GonzalezVictorJavier/Self-balancing-one-wheel-vehicle/Board.brd

## EAGLE design Board.brd (2021-12-21)

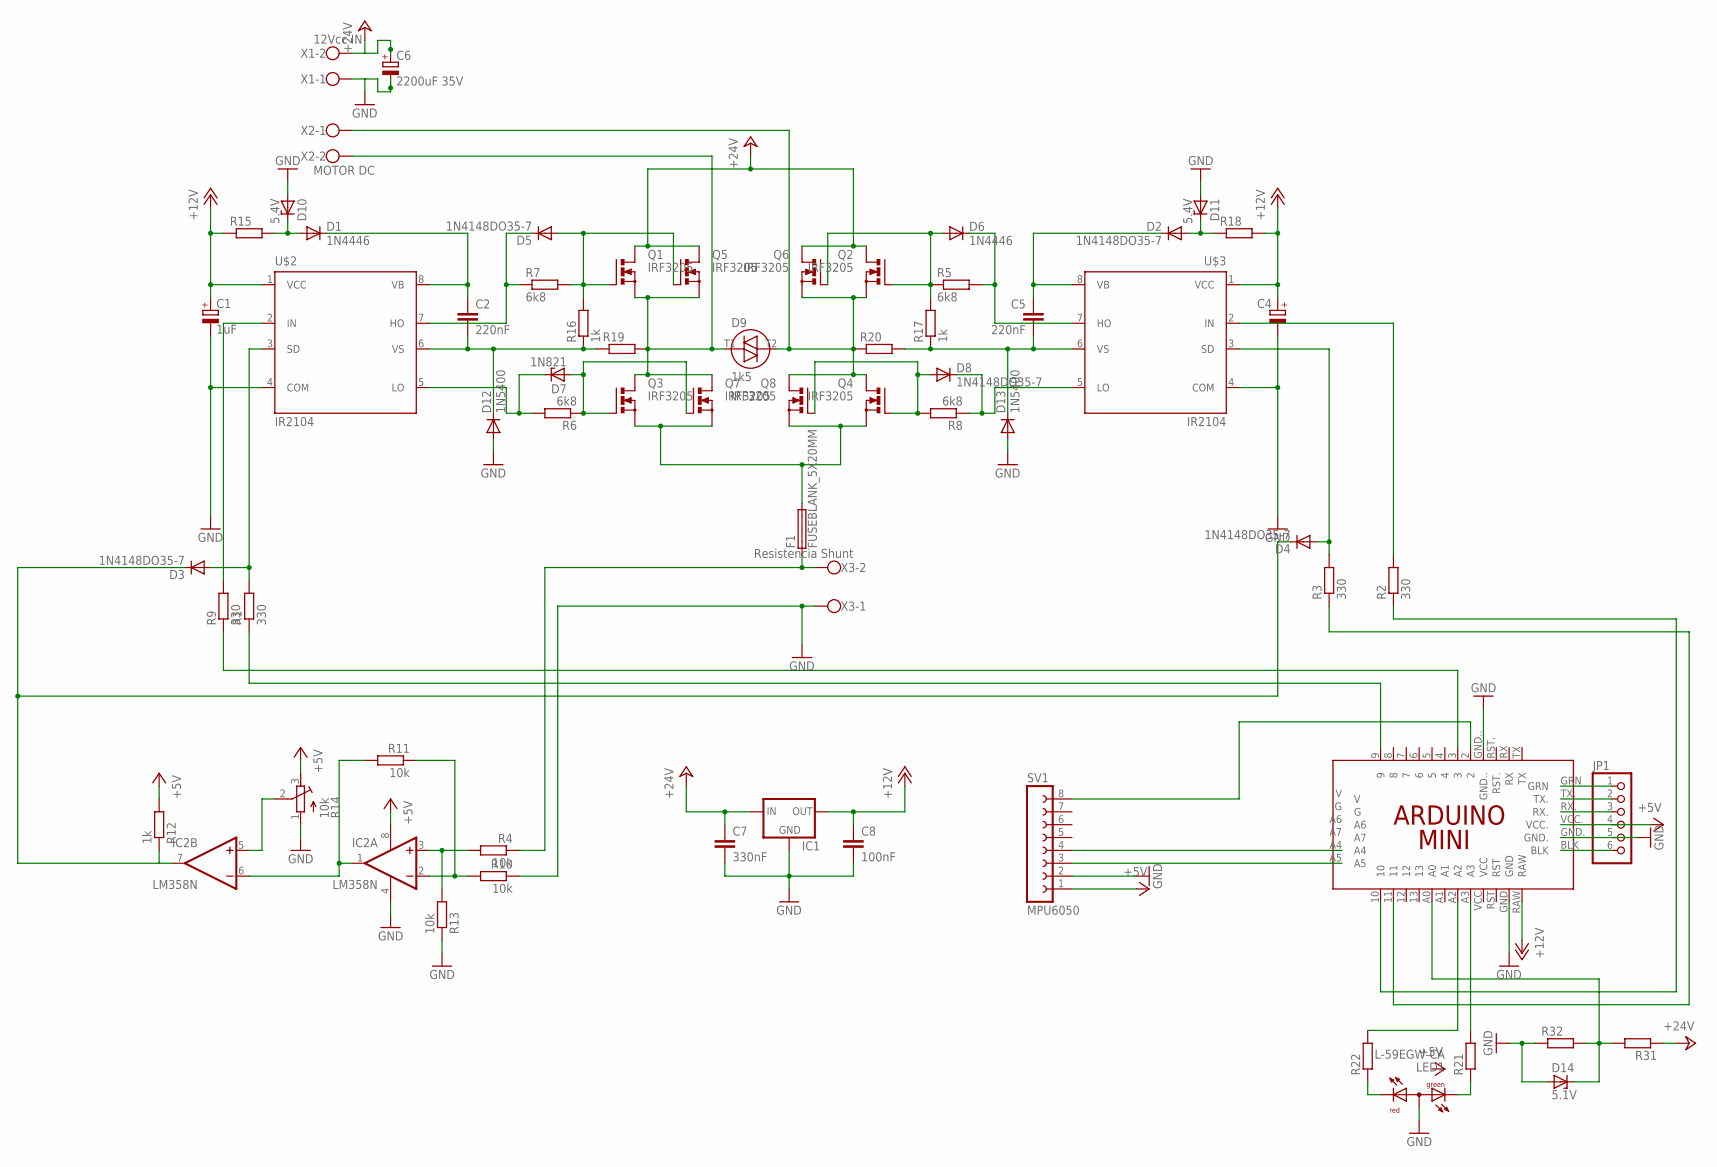
[picture p1: schematic Schematic.sch]

Parts:
C1: 1uF; E3,5-8
C2, C5: 220nF; C075-032X103
C4: CPOL-EUE3.5-8; E3,5-8
C6: 2200uF 35V; E5-13
C7: 330nF; C050-024X044
C8: 100nF; C050-024X044
D1, D6: 1N4446; DO35-10
D2, D3, D4, D5, D8: 1N4148DO35-7; DO35-7
D7: 1N821; DO35Z10
D9: 1k5; BR210S
D10, D11: 5.4V; DO34Z7
D12, D13: 1N5400; DO201-15
D14: 5.1V; DO34Z7
F1: FUSEBLANK_5X20MM; FUSE_HOLDER_5X20MM
IC1: 78XXL
IC2: LM358N; DIL08
JP1: PINHD-1X6; 1X06
LED1: L-59EGW-CA
Q1, Q2, Q3, Q4, Q5, Q6, Q7, Q8: IRF3205; TO220BV
R1: 330; 0204/7
R2, R3: 330; 0207/12
R4, R10, R11, R13: 10k; 0204/7
R5: 6k8; 0207/12
R6: 6k8; 0207/15
R7, R8: 6k8; 0204/7
R9: 330; 0207/10
R12: 1k; 0204/7
R14: 10k; RTRIM64W
R15, R18: R-EU_0204/7; 0204/7
R16, R17: 1k; 0207/10
R19, R20: R-EU_0207/15; 0207/15
R21, R22, R31, R32: R-EU_0204/5; 0204/5
SV1: MPU6050; FE08
U$1: ARDUINO_MINI_PRO+AZUL
U$2, U$3: IR2104
X1: 12Vcc IN; W237-102
X2: MOTOR DC; W237-102
X3: Resistencia Shunt; W237-102

Connections:
+5V: IC2.8 (V+), JP1.4, R12.2, R14.3 (E), SV1.1, U$1.VCC.
+12V: C1.+, C4.+, C8.1, IC1.OUT, R15.1, R18.2, U$1.RAW, U$2.1 (VCC), U$3.1 (VCC)
+24V: C6.+, C7.1, IC1.IN, Q1.D, Q2.D, Q5.D, Q6.D, R31.1, X1.2
GND: C1.-, C4.-, C6.-, C7.2, C8.2, D10.A, D11.A, D12.A, D13.A, D14.A, IC1.GND, IC2.4 (V-), JP1.5, LED1.2 (A), R10.1, R13.1, R14.1 (A), R32.1, SV1.2, U$1.GND, U$1.GND., U$1.GND.., U$2.4 (COM), U$3.4 (COM), X1.1, X3.1
unnamed: R9.2, U$2.2 (IN)
unnamed: C2.1, D1.C, U$2.8 (VB)
unnamed: F1.1, R4.1, X3.2
unnamed: D6.A, Q2.G, Q6.G, R5.1, R17.2
unnamed: R2.2, U$3.2 (IN)
unnamed: D4.A, R3.2, U$3.3 (SD)
unnamed: R1.1, U$1.9
unnamed: D3.C, D4.C, IC2.7 (OUT), R12.1
unnamed: D7.A, Q3.G, Q7.G, R6.1
unnamed: R9.1, U$1.3
unnamed: D8.A, Q4.G, Q8.G, R8.2
unnamed: C2.2, D12.C, R16.1, R19.1, U$2.6 (VS)
unnamed: D5.A, Q1.G, Q5.G, R7.2, R16.2
unnamed: SV1.3, U$1.A5
unnamed: LED1.1 (CR), R22.1
unnamed: D1.A, D10.C, R15.2
unnamed: F1.2, Q3.S, Q4.S, Q7.S, Q8.S
unnamed: R2.1, U$1.10
unnamed: C5.1, D2.C, U$3.8 (VB)
unnamed: SV1.4, U$1.A4
unnamed: IC2.1 (OUT), IC2.6 (-IN), R11.2
unnamed: D5.C, R7.1, U$2.7 (HO)
unnamed: D7.C, R6.2, U$2.5 (LO)
unnamed: D8.C, R8.1, U$3.5 (LO)
unnamed: D6.C, R5.2, U$3.7 (HO)
unnamed: IC2.3 (+IN), R4.2, R13.2
unnamed: D3.A, R1.2, U$2.3 (SD)
unnamed: D2.A, D11.C, R18.1
unnamed: LED1.3 (CG), R21.1
unnamed: IC2.2 (-IN), R10.2, R11.1
unnamed: IC2.5 (+IN), R14.2 (S)
unnamed: R3.1, U$1.11
unnamed: D9.T2, Q2.S, Q4.D, Q6.S, Q8.D, R20.1, X2.1
unnamed: D9.T1, Q1.S, Q3.D, Q5.S, Q7.D, R19.2, X2.2
unnamed: C5.2, D13.C, R17.1, R20.2, U$3.6 (VS)
unnamed: SV1.8, U$1.2
unnamed: R21.2, U$1.A3
unnamed: R22.2, U$1.A2
unnamed: JP1.6, U$1.BLK
unnamed: JP1.3, U$1.RX.
unnamed: JP1.2, U$1.TX.
unnamed: JP1.1, U$1.GRN
unnamed: D14.C, R31.2, R32.2, U$1.A0

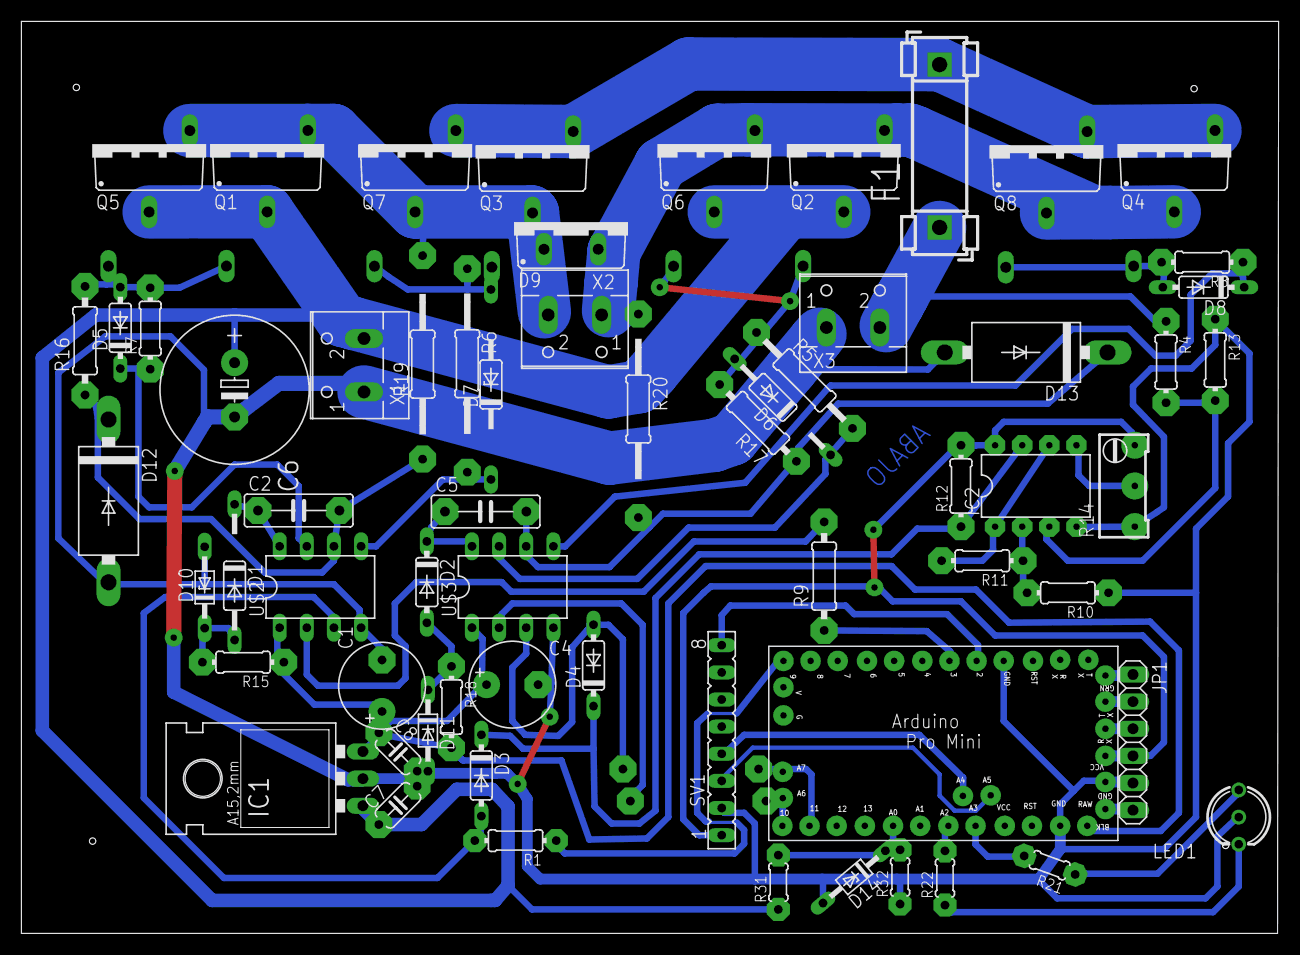
[picture p2: board Board.brd from above]

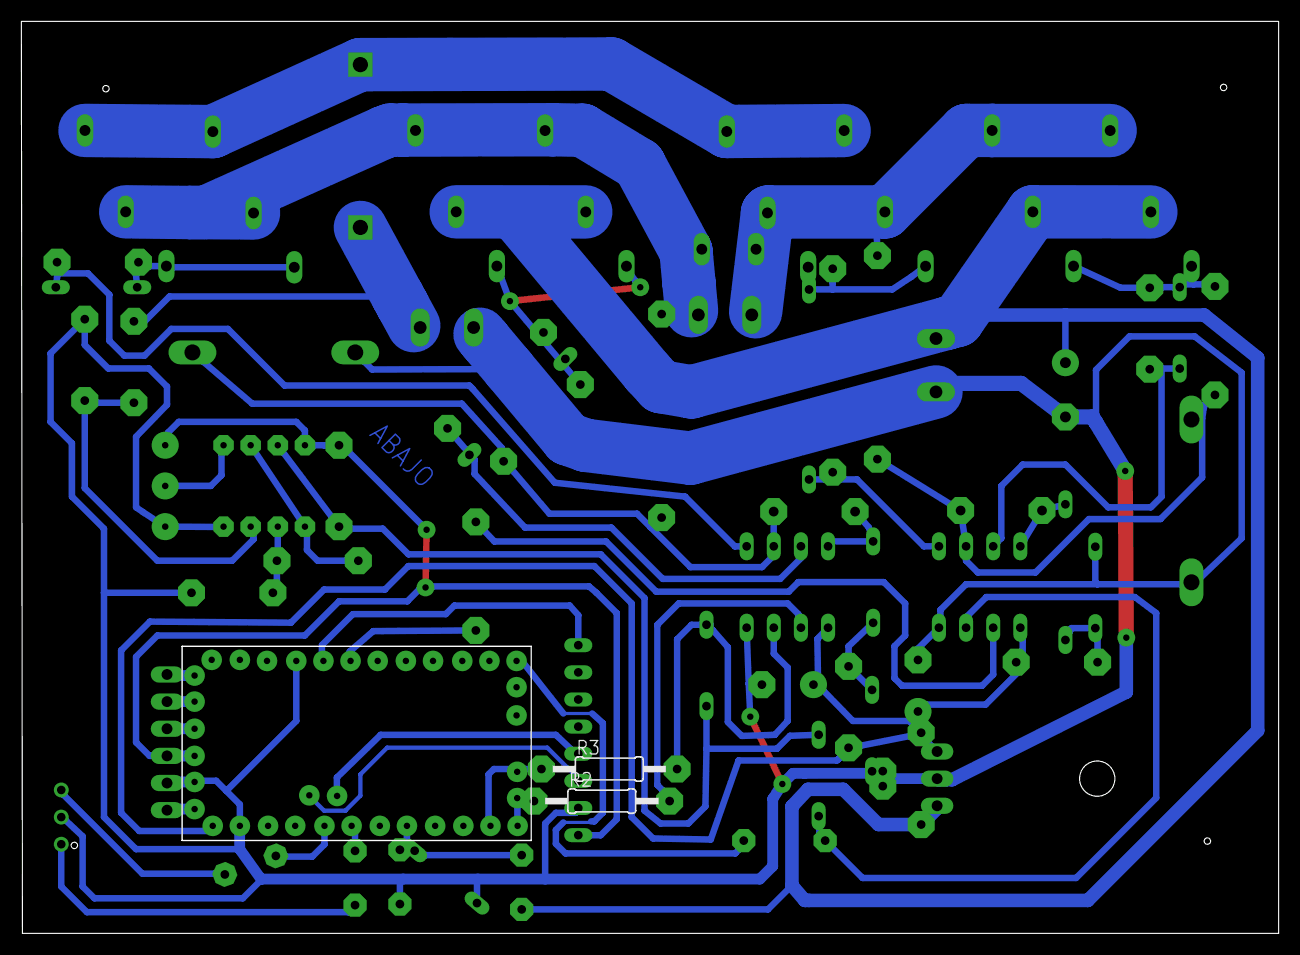
[picture p3: board Board.brd from below]

Board: 2 copper layers, 117.7 x 85.4 mm, 65 parts (2 on the bottom side), 47 nets.
