GonzalezVictorJavier/Self-balancing-one-wheel-vehicle/Code.ino

  //#include <TimerOne.h>

// I2C device class (I2Cdev) demonstration Arduino sketch for MPU6050 class using DMP (MotionApps v2.0)
// 6/21/2012 by Jeff Rowberg <jeff@rowberg.net>
// Updates should (hopefully) always be available at https://github.com/jrowberg/i2cdevlib
//
// Changelog:
//      2013-05-08 - added seamless Fastwire support
//                 - added note about gyro calibration
//      2012-06-21 - added note about Arduino 1.0.1 + Leonardo compatibility error
//      2012-06-20 - improved FIFO overflow handling and simplified read process
//      2012-06-19 - completely rearranged DMP initialization code and simplification
//      2012-06-13 - pull gyro and accel data from FIFO packet instead of reading directly
//      2012-06-09 - fix broken FIFO read sequence and change interrupt detection to RISING
//      2012-06-05 - add gravity-compensated initial reference frame acceleration output
//                 - add 3D math helper file to DMP6 example sketch
//                 - add Euler output and Yaw/Pitch/Roll output formats
//      2012-06-04 - remove accel offset clearing for better results (thanks Sungon Lee)
//      2012-06-01 - fixed gyro sensitivity to be 2000 deg/sec instead of 250
//      2012-05-30 - basic DMP initialization working

/* ============================================
I2Cdev device library code is placed under the MIT license
Copyright (c) 2012 Jeff Rowberg

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
THE SOFTWARE IS PROVIDED "AS IS", WITHOUT WARRANTY OF ANY KIND, EXPRESS OR
IMPLIED, INCLUDING BUT NOT LIMITED TO THE WARRANTIES OF MERCHANTABILITY,
FITNESS FOR A PARTICULAR PURPOSE AND NONINFRINGEMENT. IN NO EVENT SHALL THE
AUTHORS OR COPYRIGHT HOLDERS BE LIABLE FOR ANY CLAIM, DAMAGES OR OTHER
LIABILITY, WHETHER IN AN ACTION OF CONTRACT, TORT OR OTHERWISE, ARISING FROM,
OUT OF OR IN CONNECTION WITH THE SOFTWARE OR THE USE OR OTHER DEALINGS IN
THE SOFTWARE.
===============================================
*/

// I2Cdev and MPU6050 must be installed as libraries, or else the .cpp/.h files
// for both classes must be in the include path of your project
#include "I2Cdev.h"
#include "MPU6050_6Axis_MotionApps20.h"
//#include "MPU6050.h" // not necessary if using MotionApps include file
// Arduino Wire library is required if I2Cdev I2CDEV_ARDUINO_WIRE implementation
// is used in I2Cdev.h
#if I2CDEV_IMPLEMENTATION == I2CDEV_ARDUINO_WIRE
    #include "Wire.h"
#endif



MPU6050 mpu;
//MPU6050 mpu(0x69); // <-- use for AD0 high

/* =========================================================================
   NOTE: In addition to connection 3.3v, GND, SDA, and SCL, this sketch
   depends on the MPU-6050's INT pin being connected to the Arduino's
   external interrupt #0 pin. On the Arduino Uno and Mega 2560, this is
   digital I/O pin 2.
 * ========================================================================= */

/* =========================================================================
   NOTE: Arduino v1.0.1 with the Leonardo board generates a compile error
   when using Serial.write(buf, len). The Teapot output uses this method.
   The solution requires a modification to the Arduino USBAPI.h file, which
   is fortunately simple, but annoying. This will be fixed in the next IDE
   release. For more info, see these links:

   http://arduino.cc/forum/index.php/topic,109987.0.html
   http://code.google.com/p/arduino/issues/detail?id=958
 * ========================================================================= */
// uncomment "OUTPUT_READABLE_YAWPITCHROLL" if you want to see the yaw/
// pitch/roll angles (in degrees) calculated from the quaternions coming
// from the FIFO. Note this also requires gravity vector calculations.
// Also note that yaw/pitch/roll angles suffer from gimbal lock (for
// more info, see: http://en.wikipedia.org/wiki/Gimbal_lock)
#define OUTPUT_READABLE_YAWPITCHROLL

// uncomment "OUTPUT_READABLE_REALACCEL" if you want to see acceleration
// components with gravity removed. This acceleration reference frame is
// not compensated for orientation, so +X is always +X according to the
// sensor, just without the effects of gravity. If you want acceleration
// compensated for orientation, us OUTPUT_READABLE_WORLDACCEL instead.
#define OUTPUT_READABLE_REALACCEL

// MPU control/status vars
bool dmpReady = false;  // set true if DMP init was successful
uint8_t mpuIntStatus;   // holds actual interrupt status byte from MPU
uint8_t devStatus;      // return status after each device operation (0 = success, !0 = error)
uint16_t packetSize;    // expected DMP packet size (default is 42 bytes)
uint16_t fifoCount;     // count of all bytes currently in FIFO
uint8_t fifoBuffer[64]; // FIFO storage buffer

// orientation/motion vars
Quaternion q;           // [w, x, y, z]         quaternion container
VectorInt16 aa;         // [x, y, z]            accel sensor measurements
VectorInt16 aaReal;     // [x, y, z]            gravity-free accel sensor measurements
VectorInt16 aaWorld;    // [x, y, z]            world-frame accel sensor measurements
VectorFloat gravity;    // [x, y, z]            gravity vector
float ypr[3];           // [yaw, pitch, roll]   yaw/pitch/roll container and gravity vector

int16_t gx, gy, gz;


// ================================================================
// ===               INTERRUPT DETECTION ROUTINE                ===
// ================================================================

volatile bool mpuInterrupt = false;     // indicates whether MPU interrupt pin has gone high
void dmpDataReady() {
    mpuInterrupt = true;
}

//=============Inicialización de variables control driver===========
float duty = 0;
float anguloAnterior = 0;
//==================================================================
//=============Parámetros de configuración del driver===============
  //_____Lo que tiene q ver con el modelo resorte-amortiguador________
    #define ohmega 400.
    #define epsilon 15.
    #define dutyDerivConst 0.0025
  //_____Seteo de valores para el giróscopo___________________________  
    #define dutyFreno 10.
    #define anguloMuerto 0
    #define valorEsperado -10.
    #define errorMaximo 18
  //_____Seteo PWM____________________________________________________
    #define resolucionPWM 150

//==================================================================
//=======Cosas útiles para el driver================================
boolean flagMotorEncendido;
//==================================================================
//=======Definición de pines de los drivers ( tipo IR2104)==========
#define sdU1 9
#define clU1 3
#define sdU2 11
#define clU2 10
#define sensorCorriente 7
//==================================================================

unsigned long lastTime;
double Input ,Output ,Setpoint ;
double errSum ,lastErr ;
boolean flagPrimeraVez = true;

ISR(PCINT2_vect )
{
  if (digitalRead (sensorCorriente) == LOW)
  {
    flagMotorEncendido = false;
    digitalWrite(13, HIGH);
  }  
}

// ================================================================
// ===                      INITIAL SETUP                       ===
// ================================================================
void setup() {
//initialize all timers except for 0, to save time keeping functions
//    InitTimers(); 
//    lastTime = millis();
  TCCR1B = TCCR1B & 0b11111000 | 0x03;                                     //Seteamos el prescaler en 64 en ambos q son unos 490Hz
  TCCR2B = TCCR2B & 0b11111000 | 0x04;
  pinMode(clU1, OUTPUT);
  pinMode(clU2, OUTPUT);
  pinMode(sdU1, OUTPUT);
  pinMode(sdU2, OUTPUT);
  pinMode(sensorCorriente, INPUT);
  pinMode(13, OUTPUT);
  digitalWrite (sensorCorriente, HIGH);  // internal pull-up resistor
  PCMSK2 |= bit (PCINT23);  // want pin 7
  PCIFR  |= bit (PCIF2);   // clear any outstanding interrupts
  PCICR  |= bit (PCIE2);   // enable pin change interrupts for D8 to D13
  /*    pinMode(5, OUTPUT);                                                  //PWM en un sentido                                      
    SetPinFrequency(5, frecuenciaPWM);
    pwmWrite(5, 0);

    pinMode(3, OUTPUT);                                                  //PWM en un sentido                                      
    SetPinFrequency(3, frecuenciaPWM);
    pwmWrite(3, 0);

    pinMode(9, OUTPUT);                                                  //PWM en un sentido                                      
    SetPinFrequency(9, frecuenciaPWM);
    pwmWrite(9, 0);

    pinMode(10, OUTPUT);                                                  //PWM en un sentido                                      
    SetPinFrequency(10, frecuenciaPWM);
    pwmWrite(10, 0);
 */
  flagMotorEncendido = true;
   Setpoint = valorEsperado;
    // join I2C bus (I2Cdev library doesn't do this automatically)
    #if I2CDEV_IMPLEMENTATION == I2CDEV_ARDUINO_WIRE
        Wire.begin();
        TWBR = 24; // 400kHz I2C clock (200kHz if CPU is 8MHz)
    #elif I2CDEV_IMPLEMENTATION == I2CDEV_BUILTIN_FASTWIRE
        Fastwire::setup(400, true);
    #endif

    // initialize serial communication
    // (115200 chosen because it is required for Teapot Demo output, but it's
    // really up to you depending on your project)
    Serial.begin(115200);
    while (!Serial); // wait for Leonardo enumeration, others continue immediately

    // NOTE: 8MHz or slower host processors, like the Teensy @ 3.3v or Ardunio
    // Pro Mini running at 3.3v, cannot handle this baud rate reliably due to
    // the baud timing being too misaligned with processor ticks. You must use
    // 38400 or slower in these cases, or use some kind of external separate
    // crystal solution for the UART timer.

    // initialize device
    Serial.println(F("Initializing I2C devices..."));
    mpu.initialize();

    // verify connection
    Serial.println(F("Testing device connections..."));
    Serial.println(mpu.testConnection() ? F("MPU6050 connection successful") : F("MPU6050 connection failed"));

    // wait for ready
    Serial.println(F("\nSend any character to begin DMP programming and demo: "));
    while (Serial.available() && Serial.read()); // empty buffer
                                                                    //    while (!Serial.available());                 // wait for data
                                                                    //    while (Serial.available() && Serial.read()); // empty buffer again

    // load and configure the DMP
    Serial.println(F("Initializing DMP..."));
    devStatus = mpu.dmpInitialize();

    // supply your own gyro offsets here, scaled for min sensitivity
    mpu.setXGyroOffset(0);
    mpu.setYGyroOffset(0);
    mpu.setZGyroOffset(0);
    // make sure it worked (returns 0 if so)
    if (devStatus == 0) {
        // turn on the DMP, now that it's ready
        Serial.println(F("Enabling DMP..."));
        mpu.setDMPEnabled(true);

        // enable Arduino interrupt detection
        Serial.println(F("Enabling interrupt detection (Arduino external interrupt 0)..."));
        attachInterrupt(0, dmpDataReady, RISING);
        mpuIntStatus = mpu.getIntStatus();

        // set our DMP Ready flag so the main loop() function knows it's okay to use it
        Serial.println(F("DMP ready! Waiting for first interrupt..."));
        dmpReady = true;

        // get expected DMP packet size for later comparison
        packetSize = mpu.dmpGetFIFOPacketSize();
    } else {
        // ERROR!
        // 1 = initial memory load failed
        // 2 = DMP configuration updates failed
        // (if it's going to break, usually the code will be 1)
        Serial.print(F("DMP Initialization failed (code "));
        Serial.print(devStatus);
        Serial.println(F(")"));
    }
}


// ================================================================
// ===                    MAIN PROGRAM LOOP                     ===
// ================================================================

void loop() {
    // if programming failed, don't try to do anything
    if (!dmpReady) return;

    // wait for MPU interrupt or extra packet(s) available
    while (!mpuInterrupt && fifoCount < packetSize) {
        // other program behavior stuff here
        // .
        // .
        // .
        // if you are really paranoid you can frequently test in between other
        // stuff to see if mpuInterrupt is true, and if so, "break;" from the
        // while() loop to immediately process the MPU data
        // .
        // .
        // .
    }

    // reset interrupt flag and get INT_STATUS byte
    mpuInterrupt = false;
    mpuIntStatus = mpu.getIntStatus();

    // get current FIFO count
    fifoCount = mpu.getFIFOCount();

    // check for overflow (this should never happen unless our code is too inefficient)
    if ((mpuIntStatus & 0x10) || fifoCount == 1024) {
        // reset so we can continue cleanly
        mpu.resetFIFO();
        Serial.println(F("FIFO overflow!"));

    // otherwise, check for DMP data ready interrupt (this should happen frequently)
    } else if (mpuIntStatus & 0x02) {
        // wait for correct available data length, should be a VERY short wait
        while (fifoCount < packetSize) fifoCount = mpu.getFIFOCount();

        // read a packet from FIFO
        mpu.getFIFOBytes(fifoBuffer, packetSize);
        
        // track FIFO count here in case there is > 1 packet available
        // (this lets us immediately read more without waiting for an interrupt)
        fifoCount -= packetSize;

        #ifdef OUTPUT_READABLE_YAWPITCHROLL
            // display Euler angles in degrees
            mpu.dmpGetQuaternion(&q, fifoBuffer);
            mpu.dmpGetGravity(&gravity, &q);
            mpu.dmpGetYawPitchRoll(ypr, &q, &gravity);                          //Adquiere los componentes YAW, PITCH y ROL de la retación, discriminando la gravedad.
        #endif

        #ifdef OUTPUT_READABLE_REALACCEL
            // display real acceleration, adjusted to remove gravity
            mpu.dmpGetQuaternion(&q, fifoBuffer);                              //Adquiere nuevamente el Quaternion para tener una versión actualizada del mismo.
            mpu.dmpGetAccel(&aa, fifoBuffer);                                  
            mpu.dmpGetGravity(&gravity, &q);
            mpu.dmpGetLinearAccel(&aaReal, &aa, &gravity);                     //Adquiere la aceleración lineal, no se si esto no esta al pedo.. habria q probarlo porq mepa q antes usabamos esta y despues terminamos usando la de abajo nomas q es la aceleracion angular sobre x. 
            mpu.getRotation(&gx, &gy, &gz);                                    //Tomamos todas las aceleraciones angulares.
            calcularDuty(ypr[0] * 180/M_PI,ypr[1] * 180/M_PI,ypr[2] * 180/M_PI, aaReal,gz);  //LLamamos a la función que calcula y controla el duty... ????Ver q hay algunos parámetros q se pasn al pedo.. solo para graficar   
          #endif

    }
}

void calcularDuty(float medicionZ,float medicionX,float medicionY, VectorInt16 aceleracion ,int16_t accRotZ){  
  //=============Cálculo del Duty con los valores sensados========================== 
  float medicionCentrada = medicionX - valorEsperado;                                    //Ubica la medicion en el centro de las mediciones con el valorEsperado en 0  
  float dutyDeriv =   ohmega * medicionCentrada - aceleracion.x + epsilon * accRotZ;     //Ecuación que modela el sistema con el resorte-amortiguador... Devuelve la derivada del duty 
  //================================================================================
  //=============Si el sensor se va a 0, el duty va a 0 y se frena el motor=========  
  if(flagMotorEncendido == true)
  {
    duty += dutyDerivConst * dutyDeriv;                                                    //Se modifica el duty en base a la derivada anteriormente calculada.  
  }
  else
  {
      duty = 0;
  }
  duty = max(min(duty ,resolucionPWM ), - resolucionPWM);                                //Se recorta el duty en función de su resolución.
  //================================================================================
  //=============Si el duty está cercano a su valor central, clava las guampas======  
  if(duty < dutyFreno && duty > (- dutyFreno))
  {
    analogWrite(sdU1 ,255 );
    analogWrite(sdU2 ,255 );
    analogWrite(clU1, 0);  
    analogWrite(clU2, 0);  
   }
/*
  //===============================================================================
  //=============Si el Duty es negativo, va para un lado===========================
   else
   {
     if(duty < 0)
     {
       //__________Tiramos abajo los SHUT_DOWN por las dudas antes de cambiar_______
       analogWrite(sdU1 ,0 );                        
       analogWrite(sdU2 ,0 );    
       //__________Tiramos abajo los SHUT_DOWN por las dudas antes de cambiar_______
       analogWrite(clU1,  (uint8_t) abs(duty));  
       analogWrite(clU2 ,0);    
       analogWrite(sdU2, (uint8_t) abs(duty));  
       analogWrite(sdU1 ,255 );    
     }
    //===============================================================================
    //==============Si el Duty es positivo, va para el otro==========================
     else
     {
    //__________Tiramos abajo los SHUT_DOWN por las dudas antes de cambiar_______
       analogWrite(sdU1 ,0 );    
       analogWrite(sdU2 ,0 );    
       //__________Tiramos abajo los SHUT_DOWN por las dudas antes de cambiar_______
       analogWrite(clU2, (uint8_t) abs(duty));  
       analogWrite(clU1 ,0);
       analogWrite(sdU1, (uint8_t) abs(duty));  
       analogWrite(sdU2 ,255);
     }
   }
*/

  //===============================================================================
  //=============Si el Duty es negativo, va para un lado===========================
   else
   {
     if(duty < 0)
     {
       //__________Tiramos abajo los SHUT_DOWN por las dudas antes de cambiar_______
       analogWrite(clU1,  255);  
       analogWrite(clU2 ,0);    
       analogWrite(sdU1, (uint8_t) abs(duty));  
       analogWrite(sdU2 ,255 );    
     }
    //===============================================================================
    //==============Si el Duty es positivo, va para el otro==========================
     else
     {
       //__________Tiramos abajo los SHUT_DOWN por las dudas antes de cambiar_______
       analogWrite(clU2, 255);  
       analogWrite(clU1 ,0);
       analogWrite(sdU2, (uint8_t) abs(duty));  
       analogWrite(sdU1 ,255);
     }
   }

/*  

                                                                Serial.print("  ROTY\t");
                                                                Serial.print(medicionY);
                                                                 Serial.print("  ACCY  \t");
                                                                Serial.print(aceleracion.y);
                                                                 Serial.print("  ACCROTX  \t");
                                                                Serial.print(accRotX);
                                                                 Serial.print("  PWM\t");
                                                                Serial.print(duty);
                                                                 Serial.print("  DUTYDERIV  \t");
                                                                Serial.print(dutyDeriv);
                                                                 Serial.print("  DIRECCION\t");
                                                          if(medicionCentrada > anguloAnterior)
                                                          
                                                                 Serial.print("  adelante");
                                                                 else
                                                                 Serial.print("  atras");
                                                                 
                                                                 Serial.print("\n");
                                                          anguloAnterior = medicionCentrada;    
*/
}
