GonzalezVictorJavier/Self-balancing-one-wheel-vehicle/(commit log)

2021-12-21 Ver 1
    This is only the board, just for testing of a home-made H bridge to control the motor.
    [Board.brd, Schematic.sch]
2021-12-21 Ver 2
    Board: A new design using a IC H bridge driver properly calculated for the motor and mosfets.
    Algorithm: An algorithm that use a 3 axis gyro to balance itself.
    [Board.brd, Schematic.sch]
2021-12-21 Ver 3
    Board: Some adjustments at the design.
    Algorithm: Adjustments too.
    [Board.brd, Schematic.sch]
2021-12-21 Ver 4
    Board: I made a mistake and the mosfets weren't as robust as the motor require, so i put two in parallel by vertex of the H bridge (8 in total ).
    Algorithm: Some adjustments at parameters.
    [Board.brd, Schematic.sch]
2021-12-21 Ver 5
    Board: The power consumption is huge, so i needed to make thicker the board contacts. I also included a battery charge sensing.
    [Board.brd, Schematic.sch]
2021-12-21 Ver 6
    Board: I added some shunt diodes to avoid voltage spikes that could burn out the circuit.
    [Board.brd, Schematic.sch]
2021-12-21 Ver 7
    Board: Some mixed improvements:
    Algorithm: I needed to invert the X and Y axis.
    [Board.brd, Schematic.sch]
